dquadros/DQClock/Manual/AlarmParts.png

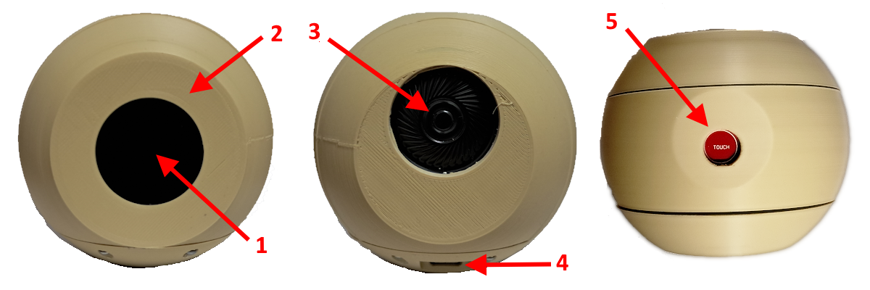
Manual/AlarmParts.png
