dquadros/DQClock/Case/corpo.stl

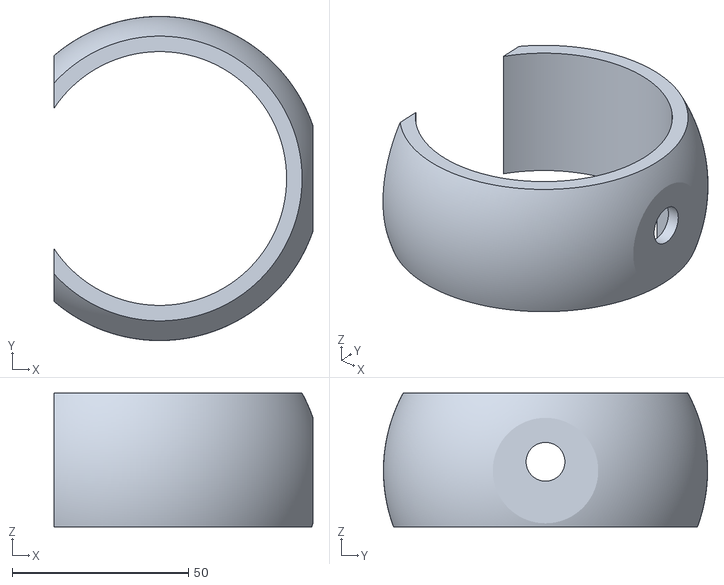
[picture p3: CAD file, 2026-10-19]
Case/corpo.stl
73.5 x 92.0 x 38.0
