dquadros/DQClock/Case/traseira.stl

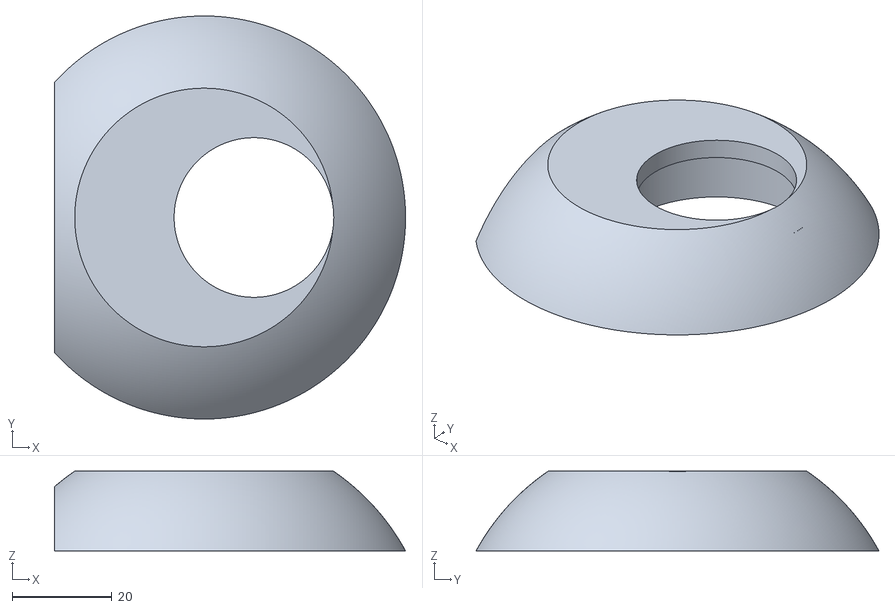
[picture p4: CAD file, 2026-10-19]
Case/traseira.stl
70.4 x 80.8 x 16.0
