dquadros/DQClock/Case/frente.stl

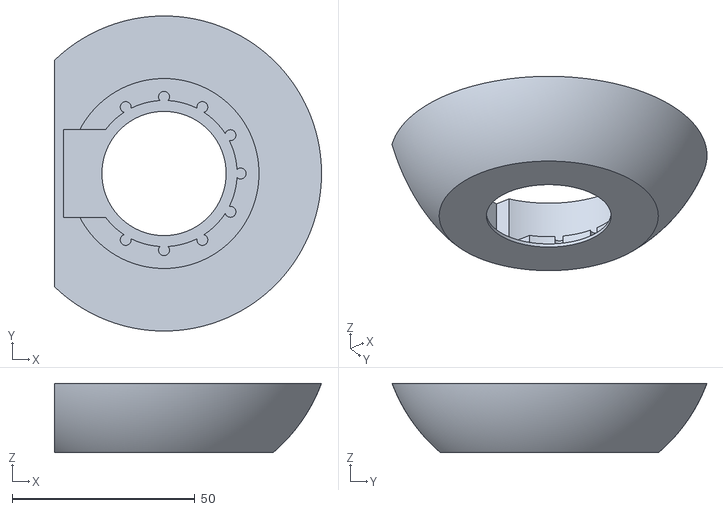
[picture p5: CAD file, 2026-10-19]
Case/frente.stl
73.1 x 86.2 x 19.0
