dquadros/DQClock/Case/base.stl

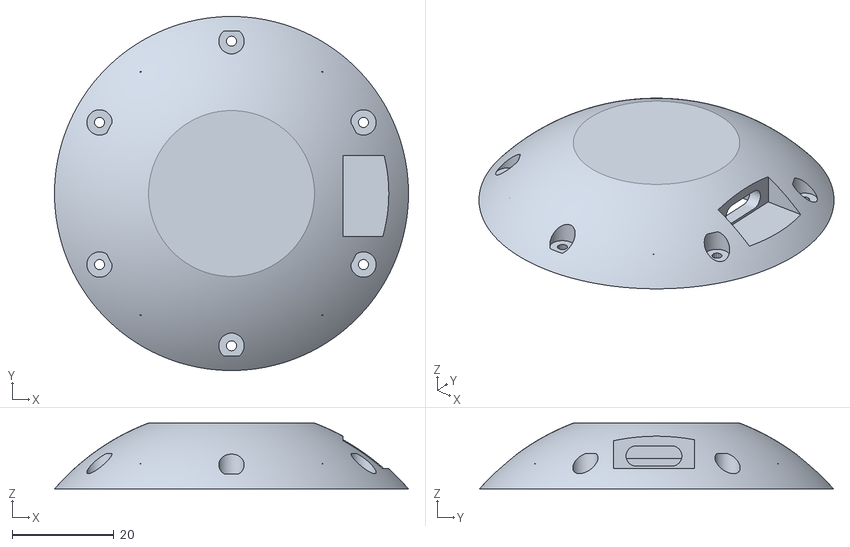
[picture p6: CAD file, 2026-10-19]
Case/base.stl
69.7 x 69.7 x 13.0
